CJHRobotics/HamBot/demos/README.md

# HamBot Demos

Runnable scripts that exercise the `robot_systems` package. This directory is symlinked to `~/Desktop/Demos` by `deploy/install.sh`, so the shortcut always points at whatever version the robot has installed.

## Prerequisites

Install the monorepo first (see the [top-level README](../README.md)):

```bash
./deploy/install.sh hambot
```

That creates `hambot_venv` with `robot_systems` installed and adds a `.bashrc` snippet so new terminals auto-activate it.

To update these scripts later, re-run the installer rather than `git pull` —
`install.sh` checks out the version it installs, which leaves the repo on a
detached HEAD that `git pull` refuses to work with:

```bash
./deploy/install.sh --ref latest hambot
```

## Demos

| Script | What it does | Hardware used |
| --- | --- | --- |
| `systems_check.py` | Prints IMU / lidar / motor status so you can verify hardware is wired correctly. | IMU, RPLidar, motors |
| `cameraGUI.py` | GUI viewer for the Pi camera stream. | Pi Camera |
| `remote_control.py` | Drive the robot with the keyboard over SSH (arrow keys + `+`/`-` for speed). One key at a time. | 2WD drive |
| `color_shuttle.py` | Drives between a blue and a pink cylinder using camera blob detection and lidar to stop. | 2WD drive, Pi Camera, RPLidar |

Run one:

```bash
python demos/remote_control.py
```

Ctrl-C stops the robot cleanly (`robot_systems` handles SIGINT and SIGTERM).

## `remote_control.py`

Works over SSH — no graphical session or extra client required. Just `ssh pi@hambot` and run it.

- `Up` / `Down` — forward / reverse.
- `Left` / `Right` — spin in place.
- `space` — stop.
- `+` / `-` — bump cruise speed (10–75 rpm).
- `q` — quit.

Tune `CRUISE_RPM_START` and the min/max speed constants at the top of the file to match your robot.

**One key drives at a time.** A terminal sends no key-release events, so
sshkeyboard infers them from gaps in the terminal's auto-repeat and tracks a
single key — pressing a new one releases the previous. Arrow keys cannot be
combined, and holding a key relies on your terminal's key repeat being enabled.

The two `RELEASE_AFTER_*` constants are the timeouts sshkeyboard uses to decide
a key was let go. `RELEASE_AFTER_FIRST_CHAR` has to outlast your terminal's
initial repeat delay (typically ~0.5 s); setting it lower makes the motors
stutter on every key press, because the release fires before the first repeat
arrives.

## `color_shuttle.py` tuning

Edit the constants near the top of the file:

- `BLUE_HSV` / `PINK_HSV` — target colors in **OpenCV HSV** (H: 0-179, S: 0-255, V: 0-255). Sample them with `cameraGUI.py` under the real lighting; only H matters for matching.
- `HUE_TOLERANCE` — ± hue units around each target. Widen if landmarks aren't detected, narrow if the robot locks onto the wrong color.
- `MIN_SATURATION` / `MIN_VALUE` — global floors that reject washed-out and dark pixels. Lower them if the color reads dim; raise them if the mask picks up walls and shadows.
- `STOP_MM` — how close (front lidar) before the robot stops.
- `CRUISE_RPM`, `SEARCH_RPM`, `STEER_KP` — motion feel.

## `cameraGUI.py`

Live HSV tuner. Click a pixel to sample its HSV into the sliders; adjust hue tolerance + S/V floors to see what gets accepted. The values plug directly into `Camera.set_target_colors(...)`.

The tuner shows one of two modes based on the sampled S value:

- **`[chromatic]`** — normal color (blue, pink, red, green…). Match band is hue ± `hue_tolerance` with S/V floors filtering out washed-out and dark pixels.
- **`[achromatic]`** — black, white, or gray. Hue is meaningless for these because near-gray pixels have unstable/undefined hue, so the matcher switches to `value ± value_tolerance` with S capped at the achromatic threshold. Click a black pixel and lower the value slider will follow — tune `value_tolerance` to widen the accepted brightness band.

Pass `value_tolerance=...` to `Camera.set_target_colors` alongside `hue_tolerance=...` when targeting black/white/gray.
