CJHRobotics/HamBot/packages/robot_systems/README.md

# HamBot: A Python Library for Robot Control

HamBot is a Python library designed to control a robot equipped with various sensors, including IMU, Lidar, and Camera. The library simplifies robot programming, providing easy-to-use interfaces for sensor data acquisition and motor control.

The physical HamBot is an open-source differential drive robot.

---

### Robot Views

<table>
  <tr>
    <td align="center"><b>Front</b></td>
    <td align="center"><b>Rear</b></td>
    <td align="center"><b>Left</b></td>
  </tr>
  <tr>
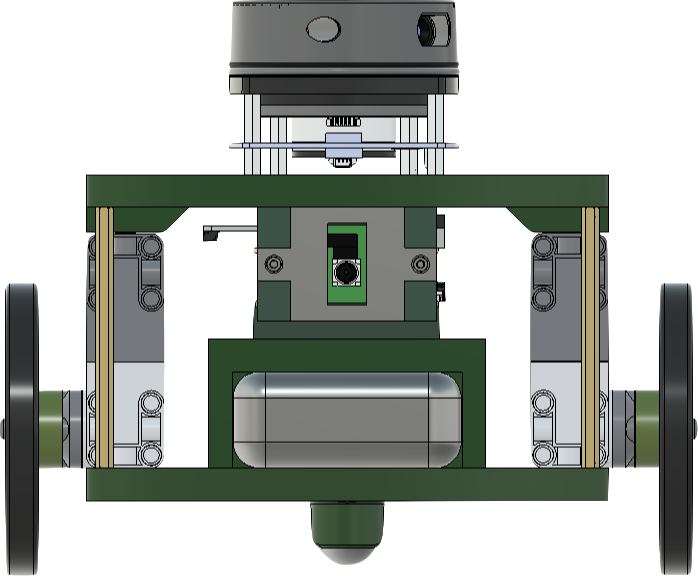
[picture p1: packages/robot_systems/docs/figures/HamBot_front_NB.png]
    <td></td>
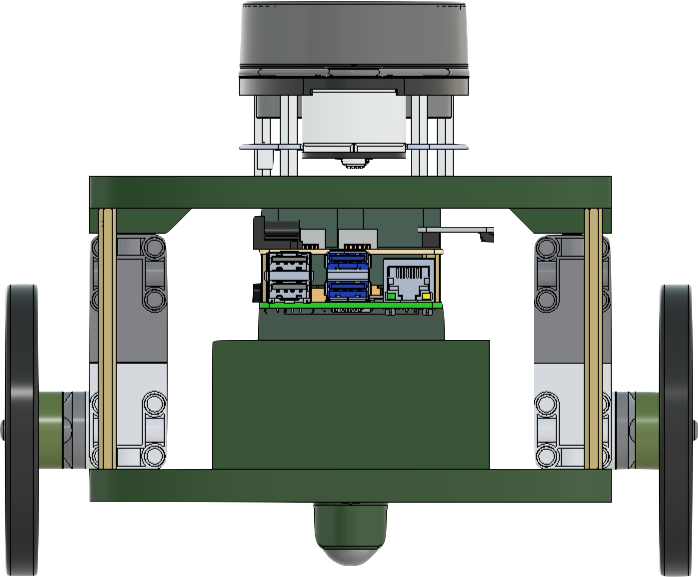
[picture p2: packages/robot_systems/docs/figures/HamBot_rear_NB.png]
    <td></td>
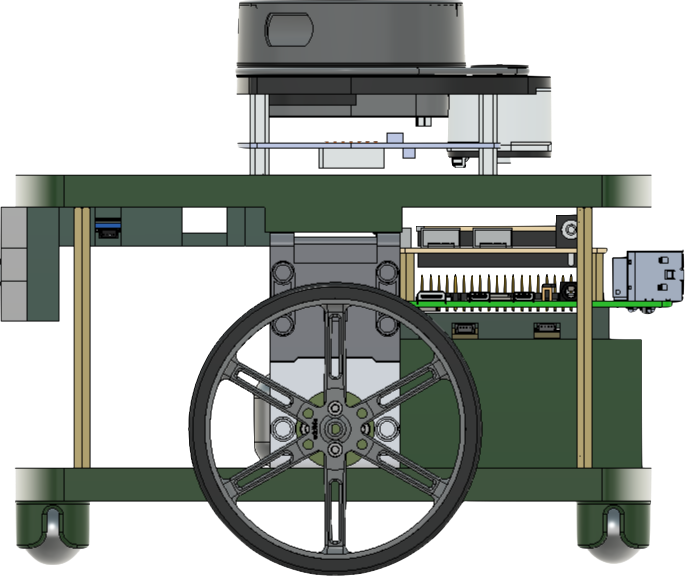
[picture p3: packages/robot_systems/docs/figures/HamBot_left_NB.png]
    <td></td>
  </tr>
  <tr>
    <td align="center"><b>Right</b></td>
    <td align="center"><b>Top</b></td>
    <td align="center"><b>Bottom</b></td>
  </tr>
  <tr>
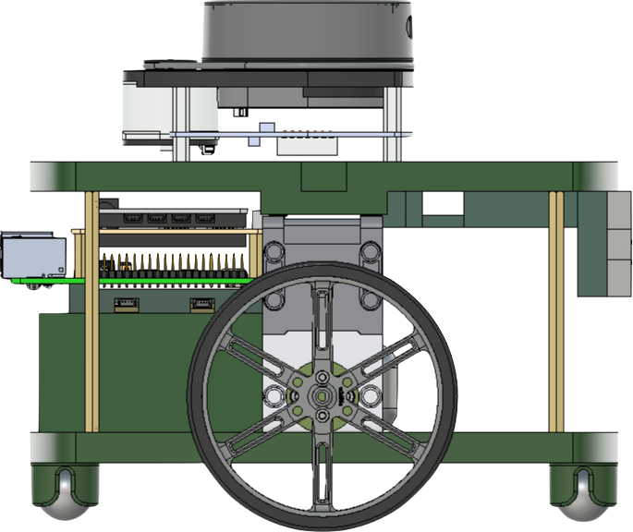
[picture p4: packages/robot_systems/docs/figures/HamBot_right_NB.png]
    <td></td>
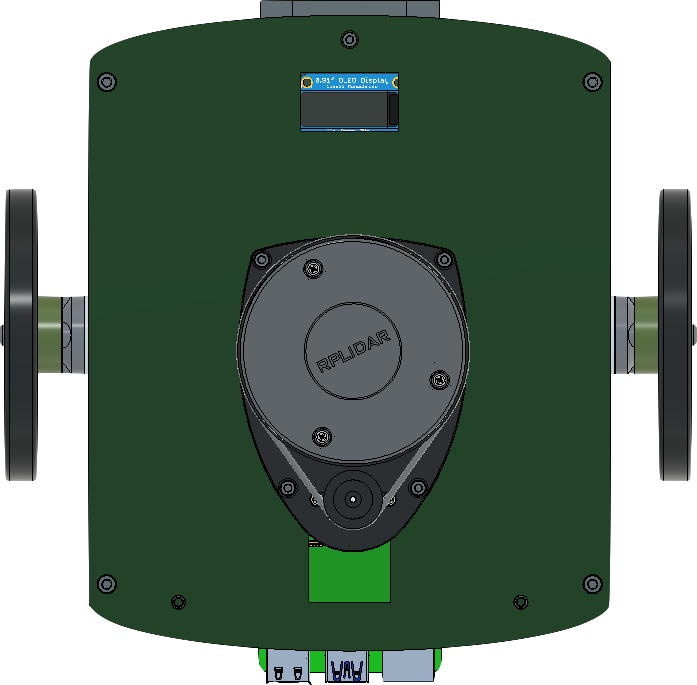
[picture p5: packages/robot_systems/docs/figures/HamBot_top_NB.png]
    <td></td>
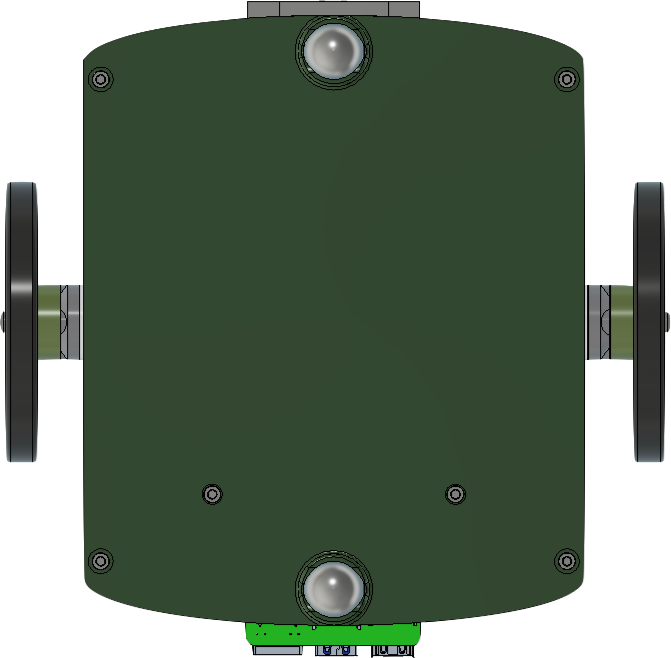
[picture p6: packages/robot_systems/docs/figures/HamBot_bottom_NB.png]
    <td></td>
  </tr>
</table>

---

### Specifications

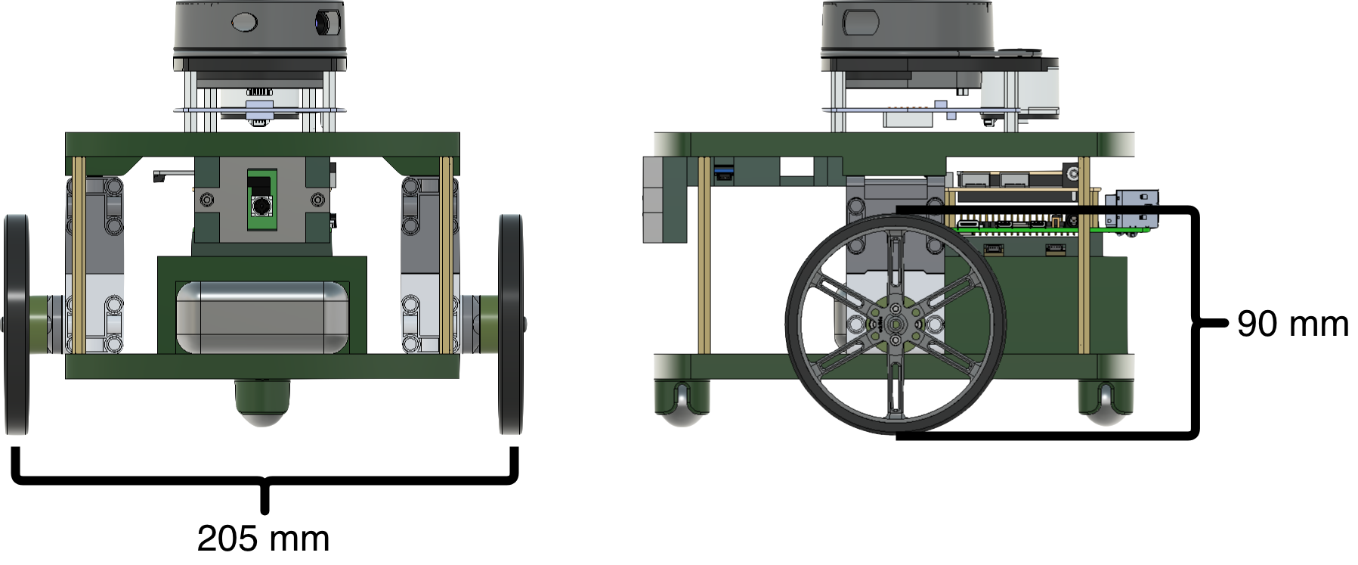
[picture p7: packages/robot_systems/docs/figures/hambot_dims.png]
HamBot Dimensions


| Characteristic | Value |
|---|---|
| Length | 200 mm |
| Width | 184 mm |
| Wheel Diameter / Radius | 90 mm / 45 mm |
| Axel Width | 205 mm |
| Height | 220 mm |
| Weight | 1.65 kg |
| Max forward/reverse wheel speed  | 0.81 m/s |
| Max forward/reverse motor speed  | 18 rad/s |

### Hardware

| Component | Details |
|---|---|
| Motors | [LEGO Technic Large Motors](https://le-www-live-s.legocdn.com/sc/media/files/support/spike-prime/techspecs_techniclargeangularmotor-1b79e2f4fbb292aaf40c97fec0c31fff.pdf) via [LEGO Build HAT](https://www.raspberrypi.com/products/build-hat/) |
| IMU | [Adafruit BNO055](https://learn.adafruit.com/adafruit-bno055-absolute-orientation-sensor/python-circuitpython) |
| LiDAR | [Slamtec RPLidar A2](https://learn.adafruit.com/slamtec-rplidar-on-pi) |
| Camera | Front-facing, 224×224, with object recognition |
| GPS | Absolute position in world frame |

---
## Features
- **Motor Control** using the Raspberry Pi Build HAT.
- **IMU Integration** with the BNO055 sensor for orientation and acceleration data.
- **Lidar Integration** with the RPLidar for distance measurements.
- **Camera Integration** with the Raspberry Pi Camera Board for image processing and landmark detection.

## Getting Started

### Prerequisites
- Raspberry Pi running Raspberry Pi OS.
- Python 3.6 or higher.
- Access to Raspberry Pi GPIO pins for motor control.
- Hardware components:
  - **IMU Sensor**: BNO055 (Adafruit CircuitPython library)
  - **Lidar Sensor**: RPLidar (Adafruit CircuitPython library)
  - **Camera**: Raspberry Pi Camera Board v2 - 8 Megapixels
  - **Motor Controller**: Raspberry Pi Build HAT

### Installation

```bash
git clone https://github.com/yourusername/robot_systems.git
cd robot_systems
python3 -m venv --system-site-packages hambot_env
source hambot_env/bin/activate
pip install -e .
````

## Hardware Components

Each component has its own documentation file with technical details and code examples:

* [IMU Sensor (BNO055)](docs/IMU.md)
* [Lidar Sensor (RPLidar)](docs/lidar.md)
* [Camera (Raspberry Pi Camera v2)](docs/camera.md)
* [Motors (Build HAT)](docs/motors.md)
* [Control Tick (`bot.step`)](docs/step.md)

## Class Outline

The main entry point is the **HamBot** class (`robot_systems/robot.py`):

```python
from robot_systems.imu import IMU
from robot_systems.lidar import Lidar
from robot_systems.camera import Camera
from buildhat import Motor

class HamBot:
    def __init__(self, lidar_enabled=True, camera_enabled=True):
        self.imu = IMU()               # Orientation & heading
        self.left_motor = Motor('B')   # Left wheel
        self.right_motor = Motor('A')  # Right wheel
        self.lidar = Lidar() if lidar_enabled else None
        self.camera = Camera() if camera_enabled else None
        # ... encoder tracking, shutdown handling ...
```

This class provides:

* `get_heading()` → orientation from the IMU
* `get_range_image()` → 360° scan from the Lidar
* `camera.get_image()` and `camera.find_landmarks()` → image capture and landmark detection
* Motor functions (`set_left_motor_speed`, `run_motors_for_seconds`, etc.)
* Encoder readings for odometry
* Safe shutdown/disconnect
---
## Usage Examples

Below are basic examples of how to use each component through the `HamBot` class.

### IMU: Get Heading
```python
from robot_systems.robot import HamBot

bot = HamBot(lidar_enabled=False, camera_enabled=False)
print("Heading (°):", bot.get_heading())
````

### LiDAR: Get Range Image

```python
from robot_systems.robot import HamBot

bot = HamBot(camera_enabled=False)
scan = bot.get_range_image()
print("Front distance (mm):", scan[180])
```

### Camera: Detect Landmarks

```python
from robot_systems.robot import HamBot

bot = HamBot(lidar_enabled=False)
bot.camera.set_landmark_colors([(255, 0, 0)], tolerance=0.08)  # detect red
landmarks = bot.camera.find_landmarks()
print("Landmarks:", landmarks)
```

### Motors: Drive Forward

```python
from robot_systems.robot import HamBot
import time

bot = HamBot(lidar_enabled=False, camera_enabled=False)

# Move forward for 2 seconds
bot.set_left_motor_speed(-50)   # left motor reversed
bot.set_right_motor_speed(50)   # right motor forward
time.sleep(2)

bot.stop_motors()
```

## Contributing

Contributions are welcome! Please submit a pull request or open an issue.

## License

MIT License – see [LICENSE](LICENSE)

## Acknowledgments

Special thanks to the developers of the libraries and hardware components used in this project.
