CJHRobotics/HamBot/packages/robot_systems/docs/HamBot2WD.3mf

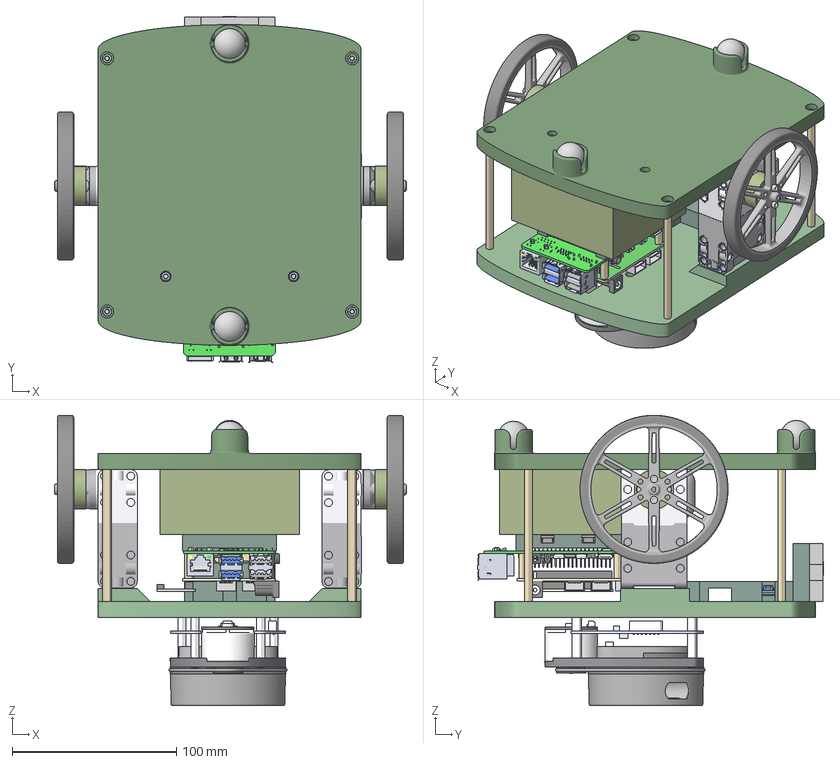
[picture p13: CAD file, 2026-05-12]
packages/robot_systems/docs/HamBot2WD.3mf
214.1 x 210.4 x 176.6 mm
