CJHRobotics/HamBot/(commit log)

2026-04-23 fixed Issue with lidar latency and lock issues
    [lidar.py]
2026-04-23 fixed Issue with IMU
    [imu.py]
2026-04-24 Resolved issue with lidar lock
    [lidar.py]
2026-04-29 Major Camera Update
2026-08-12 Restructure into a monorepo (packages/, demos/, deploy/, examples/)
    Move the flat `src/` + top-level pyproject layout to a two-package
    monorepo so the OLED display can live alongside robot_systems
    without cross-contaminating each other's dependencies.
    - packages/robot_systems/ — the existing core library (motors,
    IMU, lidar, camera). Everything under old src/robot_systems/
    moves under packages/robot_systems/src/robot_systems/.
    docs/*, LICENSE, and pyproject.toml move with it.
    - packages/hambot_oled/ — new: SSD1306 network-status display,
    installed into the shared HamBot venv alongside robot_systems.
    - deploy/ — new: install/uninstall shell scripts for the Pi, plus
    per-compon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
    [HamBot2WD.3mf]
2026-08-13 Consolidate demos, add SSH keyboard teleop
    - Merge examples/ into demos/ (cameraGUI, systems_check) so users have one place to look
    - Add demos/remote_control.py: sshkeyboard-based teleop with held-key arcing and +/- speed control
    - install.sh symlinks demos/ to ~/Desktop/Demos (git pull refreshes the shortcut); drop the examples copy
    - uninstall.sh removes the symlink and any legacy Desktop/Examples dir
    [cameraGUI.py, remote_control.py, systems_check.py]
2026-08-13 install.sh: install apt deps automatically
    - Adds python3-opencv, python3-pil.imagetk, python3-tk, network-manager, wireless-tools
    - Fixes cameraGUI ImportError on PIL.ImageTk out of the box
    - Users no longer need to run apt before install.sh
2026-08-13 cameraGUI: add Min box area slider
    Replaces the hardcoded 100 px² contour filter with a 0-2000 slider so
    users can tune blob rejection without editing the file.
    [cameraGUI.py]
2026-08-13 Switch color detection to HSV (breaking API change)
    The RGB threshold in Camera.find_landmarks fell apart under variable
    lighting: brightness shifts all three channels together, forcing a wide
    tolerance that then produced false positives. HSV separates hue from
    brightness, so hue can stay tight while lighting drifts freely.
    Public API:
    - set_target_colors now takes (H, S, V) tuples in OpenCV ranges
    (H 0-179, S 0-255, V 0-255).
    - Only hue is per-target; hue_tolerance defaults to ±10.
    - min_saturation / min_value are global floors that reject washed-out
    and dark pixels (defaults: S≥80, V≥60).
    - Hue wraparound is handled automatically (red targets etc.).
    Landmark.r/g/b renamed to h/s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
    [camera.py, cameraGUI.py, color_shuttle.py, landmark.py]
2026-08-13 Camera: match achromatic (black/white/gray) targets by value band
    Hue is unstable or undefined for near-gray pixels (V≈0 black, S≈0 white),
    so hue matching couldn't find them. Now, if a target's sampled S is
    below ACHROMATIC_S_THRESHOLD (40), the matcher switches to
    value ± value_tolerance with S capped at the threshold. Chromatic
    targets are unchanged.
    - Camera.set_target_colors: new value_tolerance parameter (default 30);
    mode is chosen automatically from the target tuple's S.
    - cameraGUI: added a Value tol slider and a [chromatic]/[achromatic]
    status indicator so users can see which branch is active.
    [camera.py, cameraGUI.py]
2026-08-13 cameraGUI: restyle with dark theme and structured layout
    - Dark palette, DejaVu Sans / DejaVu Sans Mono typography
    - Sectioned control panel: Target color, Chromatic, Achromatic, Detection
    - Aligned slider rows with label + ttk.Scale + monospace numeric readout
    - Live color swatch showing the sampled HSV as an RGB square
    - Chromatic/Achromatic mode indicated by a colored pill
    - Monospace status readout summarizing current thresholds and match count
    - Crosshair cursor over the preview, framed with a border
2026-08-14 Update robot_systems README with current HamBot specs and figures
    Sync specifications, dimensions image, and multi-view photos from the
    REALM repo so the docs reflect the actual robot instead of the outdated
    description.
2026-08-20 OLED: show hostname instead of IP address
    The network display now shows the robot's hostname alongside the
    network mode and SSID, replacing the IP address line. Hostname comes
    from socket.gethostname(), so the `ip` lookup helper is gone.
    When no network is present the screen no longer blanks; it shows the
    hostname with "No Network", since the hostname is still meaningful
    when the robot is offline.
    [network_display.py]
2026-08-25 robot_systems: handle SIGTERM and make disconnect idempotent
    HamBot only installed a SIGINT handler, so `systemctl stop` or a plain
    `kill` ended the process with the motors still turning. Register the same
    handler for SIGTERM. This matters most for anything run as a service.
    That exposed a second problem: disconnect_robot() was not safe to call
    twice. Lidar.stop_lidar() calls stop() on an already-disconnected device,
    so a signal arriving during an explicit disconnect raised. Guard it with a
    flag so repeat calls return immediately.
    signal.signal() only works on the main thread, so registration is wrapped
    in try/except ValueError - a HamBot built on a worker thread goes without
    handlers rath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
    [robot.py]
2026-08-25 Add hambot_link: control listener and camera stream for the Vivid console
    The Vivid HamBot Console drives robots and shows their camera feed over
    SSH. This is the robot half of that link.
    Two entry points, each launched per session by the console over SSH:
    hambot-link reads `<seq> <left_rpm> <right_rpm>` lines on stdin
    hambot-camera writes length-prefixed JPEG frames to stdout
    No daemon and no open port: SSH is both the transport and the
    authentication, and one SSH invocation is one session. The motors and
    camera are held only while someone is actually driving or watching, so
    student demos keep the hardware the rest of the time. That is also why the
    camera is on demand - picamera2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
2026-08-25 demos: fix stuttering and impossible key combos in remote_control
    Two bugs made the SSH teleop lag and behave inconsistently.
    listen_keyboard was called with delay_second_char=0.05. A terminal sends
    no key-release events, so sshkeyboard synthesizes them from gaps in the
    terminal's auto-repeat - and a terminal emits a held key once, waits about
    half a second, then starts repeating it. The 0.75 s default exists to
    bridge exactly that gap. At 0.05 s the release fired before the first
    repeat arrived, so every key press drove for ~60 ms, stopped for ~440 ms,
    then resumed; a tap shorter than the repeat delay drove for 60 ms and quit
    entirely. Each phantom release/press cycle also wrote to the Bui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
    [remote_control.py]
2026-08-25 hambot-camera: fix the shutdown crash, and mark fatal errors explicitly
    The hangup watcher blocked in readline() on stdin. When a session ended
    any other way - the viewer's pipe breaking, which is the normal case - the
    daemon thread was still parked there holding stdin's buffer lock, and the
    interpreter aborted on it:
    Fatal Python error: _enter_buffered_busy: could not acquire lock for
    <_io.BufferedReader name='<stdin>'> at interpreter shutdown
    Poll the raw descriptor with select instead, so the watcher notices the
    session ending and returns; join it before teardown. Wrap the streaming
    call so a failure there is reported rather than surfacing as whatever the
    interpreter says on its way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
    [camera_stream.py, teleop.py]
2026-08-25 hambot-camera: give picamera2 the IO type it type-checks for
    The stream never produced a frame:
    streaming failed: Must pass io.BufferedIOBase
    FileOutput validates its argument with isinstance(file, io.BufferedIOBase)
    and rejects anything else, however complete its write/flush pair looks.
    FrameWriter was a plain class, so recording never started.
    Make it a real io.BufferedIOBase. Everything FileOutput actually needs was
    already there - it only calls write() then flush() - and subclassing also
    takes closed/close() from the standard machinery, which the control loop
    and the hangup watcher both read, so the hand-rolled flag goes away.
    Verified against the genuine FileOutput from the picame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
    [camera_stream.py]
2026-09-01 hambot-oled: show hostname, IP, and SSID without labels
    The panel is 128x32 with a 6px font — about 21 characters per line — so a
    prefix like "SSID: " costs six of them. Drop the labels and the Mode line,
    and spend the space on the address you actually need to reach the robot:
    hambot-07
    192.168.50.63
    Robobulls_Network_EN..
    The IP line prefers the Wi-Fi interface's address so it describes the same
    connection the SSID line names, and falls back to any other non-loopback
    address so a robot on Ethernet still shows something you can ssh to.
    Dropping the labels isn't enough on its own: Robobulls_Network_ENG122B is 25
    characters, so text is now measured and truncated with a ".."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
2026-09-03 deploy: let install.sh pin the version it installs
    Every robot tracks main through `git clone` + `git pull`, so a bad commit on
    main breaks the whole fleet with no way back short of hand-editing on each Pi.
    `--ref` checks out a version before installing, defaulting to the newest
    `vX.Y.Z` tag, so `install.sh` alone restores a robot to the last known-good
    release. `--ref main` follows development, `--ref current` installs the
    checkout untouched.
    The checkout can replace install.sh mid-run and bash reads scripts
    incrementally, so hand off to the newly checked-out copy rather than running a
    mix of both. `--ref` is stripped from that hand-off: releases predating the
    flag reject it outright, whi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
2026-09-03 deploy: replace the 'git pull' update path with install.sh --ref
    install.sh now checks out the version it installs, which leaves every robot on
    a detached HEAD. The docs still told students to run `git pull`, which fails
    there with "You are not currently on a branch" — so the documented way to
    update a robot was broken for every robot that had been installed.
    Point the update path at the installer instead, which fetches, checks out, and
    reinstalls in one step. uninstall.sh now reports the version it removed and,
    when the checkout is detached, says how to get back on a branch for
    development.
2026-09-03 deploy: make install.sh refuse a bare run on a feature branch
    Omitting --ref defaults to 'latest', which is right for a robot but wrong for
    whoever is developing: on a feature branch it silently detached the checkout to
    a release, so the branch under test was not the code installed. The failure is
    quiet — the install succeeds, and the change appears not to work.
    Robots stay unaffected: on main or already detached, the bare run still
    installs latest with no prompt. Only a non-main branch, where a default cannot
    be guessed safely, now requires --ref current or --ref latest.
2026-09-03 deploy: default --ref to 'current' so the caller owns version selection
    The lab Ansible playbook (hambots/hambot-installation/) already checks out
    hambot_repo_version before invoking this script, so defaulting to 'latest' gave
    the fleet two competing version authorities — and install.sh won. A run pinned
    with -e hambot_repo_version=v0.3.0 would have been silently replaced by the
    newest tag.
    It also broke the roll-out outright on robots the playbook deliberately leaves
    dirty (it sets force:false so "a robot mid-experiment with edits keeps them"):
    the uncommitted-changes guard turned those into hard failures, and serial:20%
    would stop the wave.
    Defaulting to 'current' makes the bare invoca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
2026-09-03 docs: add HANDOFF.md for the backend abstraction work
    Records the design settled in this cycle so the next session starts from it
    rather than re-deriving it: the three-layer split, step() semantics, the
    backend protocol seam, and the daemon requirements.
    Deliberately includes the decisions that are already closed and why — the
    camera staying outside the container, install.sh --ref defaulting to 'current',
    OpenCR implying a drivetrain rebuild, firmware living in its own repo — because
    each is a plausible-looking move to undo without the reasoning attached. Open
    decisions (step() overrun policy, protocol altitude) are marked as open rather
    than papered over.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
2026-09-10 fix: don't import the OAK-D backend when asked for the Pi camera
    Camera.create() imported both backends before dispatching, and oak_camera
    imports depthai at module scope. On any robot without depthai installed,
    asking for the Pi camera raised ModuleNotFoundError — and HamBot.__init__
    catches that and sets camera = None, so student code on a robot with a
    perfectly good Pi camera silently had no camera at all, with one printed line
    at construction as the only clue.
    Import each backend inside the branch that returns it. Found by the fleet
    systems-check playbook, which goes through the factory precisely because that
    is the path student code takes.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
    [camera.py]
2026-09-10 fix: update the camera backends to the HSV matcher's signature
    821c8a9 replaced Camera.__init__'s fractional `tolerance` with the HSV
    parameters (hue_tolerance, min_saturation, min_value, value_tolerance) and
    updated color_shuttle.py and cameraGUI.py — but not PiCamera, OakCamera, or
    demos/systems_check.py, which all still passed `tolerance=`.
    So neither camera backend could be constructed at all: every call raised
    TypeError from super().__init__. Nobody saw it because HamBot catches any
    camera exception and sets camera = None, and on robots without depthai the
    factory raised even earlier (fixed in v0.2.1) — two layers of silence over a
    camera stack that hasn't worked since the HSV swit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
    [oak_camera.py, pi_camera.py, systems_check.py]
2026-09-17 oled: show the SSID on the air, not the profile's name
    A robot on its fallback hotspot displayed "hambot-fallback-ap" — the name of
    the NetworkManager profile, identical on every robot in the fleet, and not
    the name of any network a student can join. GENERAL.CONNECTION is the profile;
    the profile's own ssid field is what is being broadcast, which for the
    fallback AP is the robot's hostname.
    Resolves the profile, then asks it for its SSID, quoting the name because
    profiles legitimately contain spaces ("Wired connection 1"). A profile with no
    ssid field falls back to its name, which still beats a blank line.
2026-09-18 robot_systems: add a control tick with freshness and coherence guarantees
    HamBot was free-running: background threads updated sensors on their own
    schedules, so two getters called in sequence could describe different
    instants, and a lidar slot from 30 s ago was indistinguishable from a fresh
    one. This adds the tick HANDOFF.md §3.1 calls for.
    while bot.step(0.05):
    scan = bot.get_range_image() # these two describe
    heading = bot.get_heading() # the same instant
    step() flushes coalesced commands, waits to the period boundary, then samples
    every sensor once into a Snapshot the getters read from. Flushing before the
    wait means a speed is acted on for the whole per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
2026-10-22 HANDOFF: record the hambot-07 validation results
    Four of §7's six boxes are now verified on hardware, with measurements rather
    than reasoning:
    - dt=0.05 holds with real sensor I/O — 50.0 ms median, 0 overruns in 200
    cycles with lidar, IMU and camera live. This was the result that could have
    forced a redesign.
    - stale_after_s=1.0 is correct. Measured median slot age is 138 ms, matching
    the 5-10 Hz spin the default was reasoned from. The distribution is bimodal
    and 1.0 s separates it cleanly; only 21 of 360 slots change behaviour, and
    those were last measured seconds ago. Default stays.
    - Pinning is proven, but only after the first test turned out to be vacuous:
    a stationary ro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
2026-10-22 HANDOFF: close the last two §7 boxes — demos and Ctrl-C passed on hambot-07
    All four demos ran unmodified, which is the gate: they are the compatibility
    suite, so an edit would have meant the API changed. That run also exercises the
    free-running path, which ticked_drive.py does not touch.
    Ctrl-C stopped the motors at dt=0.5, where the signal lands inside the step()
    wait rather than in the loop body — the path the RLock fix exists for.
    Step 1 is done.
2026-10-23 imu: retire the heading-conversion TODO, it is verified
    The east-referenced conversion carried a '# TODO :verify it works' since it was
    written. hambot-07 settles it: facing north the sensor reads yaw 0 and
    get_heading() returns 90.0, and hand-rotating tracks in 1/16-degree steps, the
    BNO055's euler LSB. Replaced the TODO with what the hardware showed, so the
    next reader does not re-litigate the convention.
    Comment only — no behaviour change, so v0.3.0 is unaffected.
